tekoler/Mikroprozessortechnik_SimonSays/README.md

This Repository shows the process of my schoolprojekt at TEKO Zurich.

The plan is to create a SimonSays-Game
