tekoler/Mikroprozessortechnik_SimonSays/(list of files, drawings)

Other design files:
Mikroprozessortechnik_SimonSays_V1.0.fzz
Mikroprozessortechnik_SimonSays_V2.0.fzz
