tekoler/Mikroprozessortechnik_SimonSays/(commit log)

2024-11-14 'first commit - basic LED and Button functions'
2024-11-15 Tone for buttons, simonPlays, solutionChecker
2024-11-18 Buttons ohne Widerstand
2024-11-25 Fritzing Schema included
    [Mikroprozessortechnik_SimonSays_V1.0.fzz]
2024-11-26 -Startup Sequenz mit Ton und LED -Button debouncer mit Millis -Winning und Losing Ton und LED Sequenz
2024-11-29 -Buttonpressing verbessert. Es ist nun möglich schneller zu drücken -richtiges Random mit randomSeed -Display mit Levelanzeige integriert -Multiplayer beginn
2024-12-09 -Multiplayer funktionstüchtig -Einstellungen Helligkeit, Lautstärke und Speed möglich
